lonelygoddady/EE209AS_Smart_blackboard_eraser/Camera/image.bmp

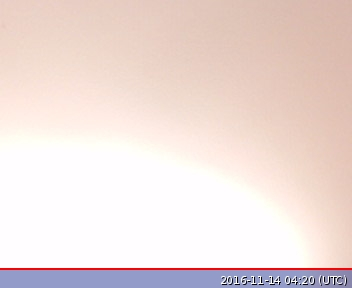
Camera/image.bmp
