lonelygoddady/EE209AS_Smart_blackboard_eraser/Final version/README.md

The Main.py file is the program main of the system. It contains image processing algorithm for the camera and the UI code. 

Motor_control folder contains the final version of arduino motor control code

Communication_send folder contains the arduino RF24 data sending code

Three 'Project_GUI_v2' files are GUI support files Main.py function will use
