lonelygoddady/EE209AS_Smart_blackboard_eraser/GUI/v7/Display.png

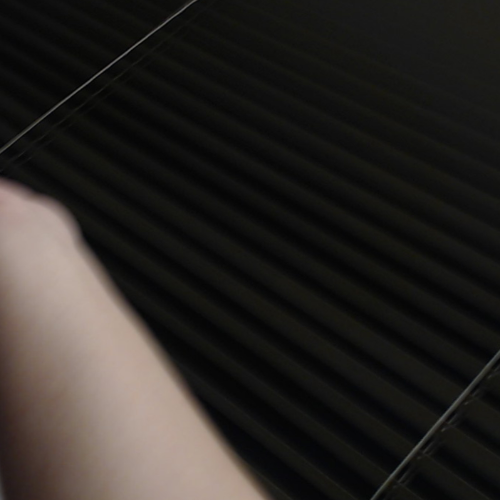
GUI/v7/Display.png
