lonelygoddady/EE209AS_Smart_blackboard_eraser/Final version/Project_GUI_v2.py

# -*- coding: utf-8 -*-

# Form implementation generated from reading ui file 'Project_GUI_v2.ui'
#
# Created: Mon Dec  5 13:35:02 2016
#      by: PyQt4 UI code generator 4.11.2
#
# WARNING! All changes made in this file will be lost!

from PyQt4 import QtCore, QtGui

try:
    _fromUtf8 = QtCore.QString.fromUtf8
except AttributeError:
    def _fromUtf8(s):
        return s

try:
    _encoding = QtGui.QApplication.UnicodeUTF8
    def _translate(context, text, disambig):
        return QtGui.QApplication.translate(context, text, disambig, _encoding)
except AttributeError:
    def _translate(context, text, disambig):
        return QtGui.QApplication.translate(context, text, disambig)

class Ui_MainWindow(object):
    def setupUi(self, MainWindow):
        MainWindow.setObjectName(_fromUtf8("MainWindow"))
        MainWindow.resize(1014, 555)
        sizePolicy = QtGui.QSizePolicy(QtGui.QSizePolicy.Expanding, QtGui.QSizePolicy.Expanding)
        sizePolicy.setHorizontalStretch(0)
        sizePolicy.setVerticalStretch(0)
        sizePolicy.setHeightForWidth(MainWindow.sizePolicy().hasHeightForWidth())
        MainWindow.setSizePolicy(sizePolicy)
        self.centralwidget = QtGui.QWidget(MainWindow)
        self.centralwidget.setObjectName(_fromUtf8("centralwidget"))
        self.gridLayout = QtGui.QGridLayout(self.centralwidget)
        self.gridLayout.setObjectName(_fromUtf8("gridLayout"))
        self.horizontalLayout = QtGui.QHBoxLayout()
        self.horizontalLayout.setObjectName(_fromUtf8("horizontalLayout"))
        self.label_area = QtGui.QLabel(self.centralwidget)
        sizePolicy = QtGui.QSizePolicy(QtGui.QSizePolicy.Expanding, QtGui.QSizePolicy.Expanding)
        sizePolicy.setHorizontalStretch(0)
        sizePolicy.setVerticalStretch(0)
        sizePolicy.setHeightForWidth(self.label_area.sizePolicy().hasHeightForWidth())
        self.label_area.setSizePolicy(sizePolicy)
        self.label_area.setFrameShape(QtGui.QFrame.Box)
        self.label_area.setText(_fromUtf8(""))
        self.label_area.setObjectName(_fromUtf8("label_area"))
        self.horizontalLayout.addWidget(self.label_area)
        self.verticalLayout_2 = QtGui.QVBoxLayout()
        self.verticalLayout_2.setObjectName(_fromUtf8("verticalLayout_2"))
        self.verticalLayout = QtGui.QVBoxLayout()
        self.verticalLayout.setObjectName(_fromUtf8("verticalLayout"))
        self.textBrowser = QtGui.QTextBrowser(self.centralwidget)
        sizePolicy = QtGui.QSizePolicy(QtGui.QSizePolicy.Preferred, QtGui.QSizePolicy.Expanding)
        sizePolicy.setHorizontalStretch(0)
        sizePolicy.setVerticalStretch(0)
        sizePolicy.setHeightForWidth(self.textBrowser.sizePolicy().hasHeightForWidth())
        self.textBrowser.setSizePolicy(sizePolicy)
        self.textBrowser.setMaximumSize(QtCore.QSize(160, 16777215))
        self.textBrowser.setObjectName(_fromUtf8("textBrowser"))
        self.verticalLayout.addWidget(self.textBrowser)
        spacerItem = QtGui.QSpacerItem(20, 40, QtGui.QSizePolicy.Minimum, QtGui.QSizePolicy.Expanding)
        self.verticalLayout.addItem(spacerItem)
        self.Cancel = QtGui.QPushButton(self.centralwidget)
        sizePolicy = QtGui.QSizePolicy(QtGui.QSizePolicy.Preferred, QtGui.QSizePolicy.Fixed)
        sizePolicy.setHorizontalStretch(0)
        sizePolicy.setVerticalStretch(0)
        sizePolicy.setHeightForWidth(self.Cancel.sizePolicy().hasHeightForWidth())
        self.Cancel.setSizePolicy(sizePolicy)
        self.Cancel.setMaximumSize(QtCore.QSize(160, 16777215))
        self.Cancel.setObjectName(_fromUtf8("Cancel"))
        self.verticalLayout.addWidget(self.Cancel)
        self.Update = QtGui.QPushButton(self.centralwidget)
        sizePolicy = QtGui.QSizePolicy(QtGui.QSizePolicy.Preferred, QtGui.QSizePolicy.Fixed)
        sizePolicy.setHorizontalStretch(0)
        sizePolicy.setVerticalStretch(0)
        sizePolicy.setHeightForWidth(self.Update.sizePolicy().hasHeightForWidth())
        self.Update.setSizePolicy(sizePolicy)
        self.Update.setMaximumSize(QtCore.QSize(160, 16777215))
        self.Update.setObjectName(_fromUtf8("Update"))
        self.verticalLayout.addWidget(self.Update)
        self.Save = QtGui.QPushButton(self.centralwidget)
        sizePolicy = QtGui.QSizePolicy(QtGui.QSizePolicy.Preferred, QtGui.QSizePolicy.Fixed)
        sizePolicy.setHorizontalStretch(0)
        sizePolicy.setVerticalStretch(0)
        sizePolicy.setHeightForWidth(self.Save.sizePolicy().hasHeightForWidth())
        self.Save.setSizePolicy(sizePolicy)
        self.Save.setMaximumSize(QtCore.QSize(160, 16777215))
        self.Save.setObjectName(_fromUtf8("Save"))
        self.verticalLayout.addWidget(self.Save)
        self.Calibrate = QtGui.QPushButton(self.centralwidget)
        sizePolicy = QtGui.QSizePolicy(QtGui.QSizePolicy.Preferred, QtGui.QSizePolicy.Fixed)
        sizePolicy.setHorizontalStretch(0)
        sizePolicy.setVerticalStretch(0)
        sizePolicy.setHeightForWidth(self.Calibrate.sizePolicy().hasHeightForWidth())
        self.Calibrate.setSizePolicy(sizePolicy)
        self.Calibrate.setMaximumSize(QtCore.QSize(160, 16777215))
        self.Calibrate.setObjectName(_fromUtf8("Calibrate"))
        self.verticalLayout.addWidget(self.Calibrate)
        spacerItem1 = QtGui.QSpacerItem(20, 20, QtGui.QSizePolicy.Minimum, QtGui.QSizePolicy.Preferred)
        self.verticalLayout.addItem(spacerItem1)
        self.Clear = QtGui.QPushButton(self.centralwidget)
        sizePolicy = QtGui.QSizePolicy(QtGui.QSizePolicy.Preferred, QtGui.QSizePolicy.Expanding)
        sizePolicy.setHorizontalStretch(0)
        sizePolicy.setVerticalStretch(0)
        sizePolicy.setHeightForWidth(self.Clear.sizePolicy().hasHeightForWidth())
        self.Clear.setSizePolicy(sizePolicy)
        self.Clear.setMaximumSize(QtCore.QSize(160, 16777215))
        self.Clear.setStyleSheet(_fromUtf8("background-color: yellow"))
        self.Clear.setObjectName(_fromUtf8("Clear"))
        self.verticalLayout.addWidget(self.Clear)
        self.verticalLayout_2.addLayout(self.verticalLayout)
        self.horizontalLayout.addLayout(self.verticalLayout_2)
        self.gridLayout.addLayout(self.horizontalLayout, 0, 0, 1, 1)
        MainWindow.setCentralWidget(self.centralwidget)
        self.statusbar = QtGui.QStatusBar(MainWindow)
        self.statusbar.setObjectName(_fromUtf8("statusbar"))
        MainWindow.setStatusBar(self.statusbar)
        self.toolBar = QtGui.QToolBar(MainWindow)
        self.toolBar.setObjectName(_fromUtf8("toolBar"))
        MainWindow.addToolBar(QtCore.Qt.TopToolBarArea, self.toolBar)

        self.retranslateUi(MainWindow)
        QtCore.QMetaObject.connectSlotsByName(MainWindow)

    def retranslateUi(self, MainWindow):
        MainWindow.setWindowTitle(_translate("MainWindow", "MainWindow", None))
        self.Cancel.setText(_translate("MainWindow", "Cancel Select", None))
        self.Update.setText(_translate("MainWindow", "Update Content", None))
        self.Save.setText(_translate("MainWindow", "Save Content", None))
        self.Calibrate.setText(_translate("MainWindow", "Calibrate", None))
        self.Clear.setText(_translate("MainWindow", "Clear Content", None))
        self.toolBar.setWindowTitle(_translate("MainWindow", "toolBar", None))
